adnanzami/IoT-based-Intelligent-Clothes-Dryer-Rack---Automated-Motorized-Cloth-Dryer-System/Schematics/motor driver schematic.jpg

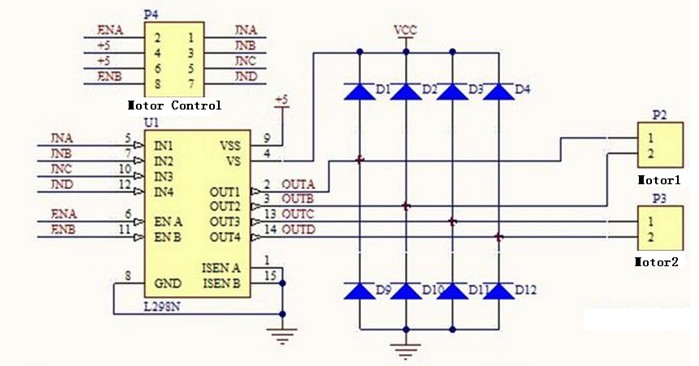
Schematics/motor driver schematic.jpg
