adnanzami/IoT-based-Intelligent-Clothes-Dryer-Rack---Automated-Motorized-Cloth-Dryer-System/Schematics/roller.jpg

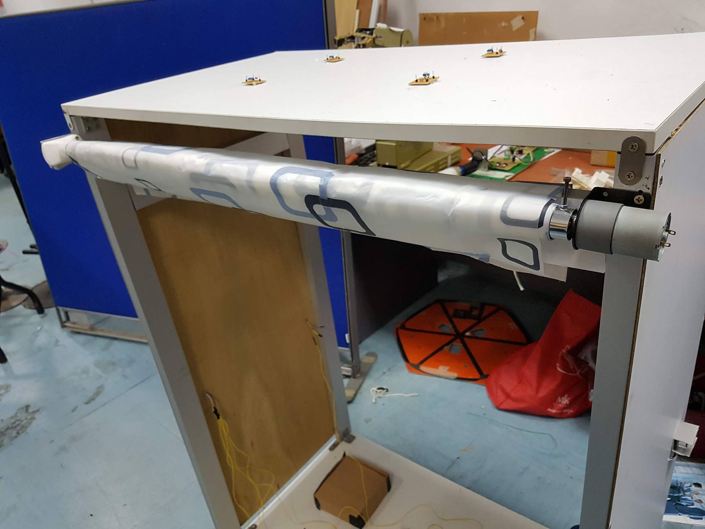
Schematics/roller.jpg
