adnanzami/IoT-based-Intelligent-Clothes-Dryer-Rack---Automated-Motorized-Cloth-Dryer-System/Code/LDR/LDR.png

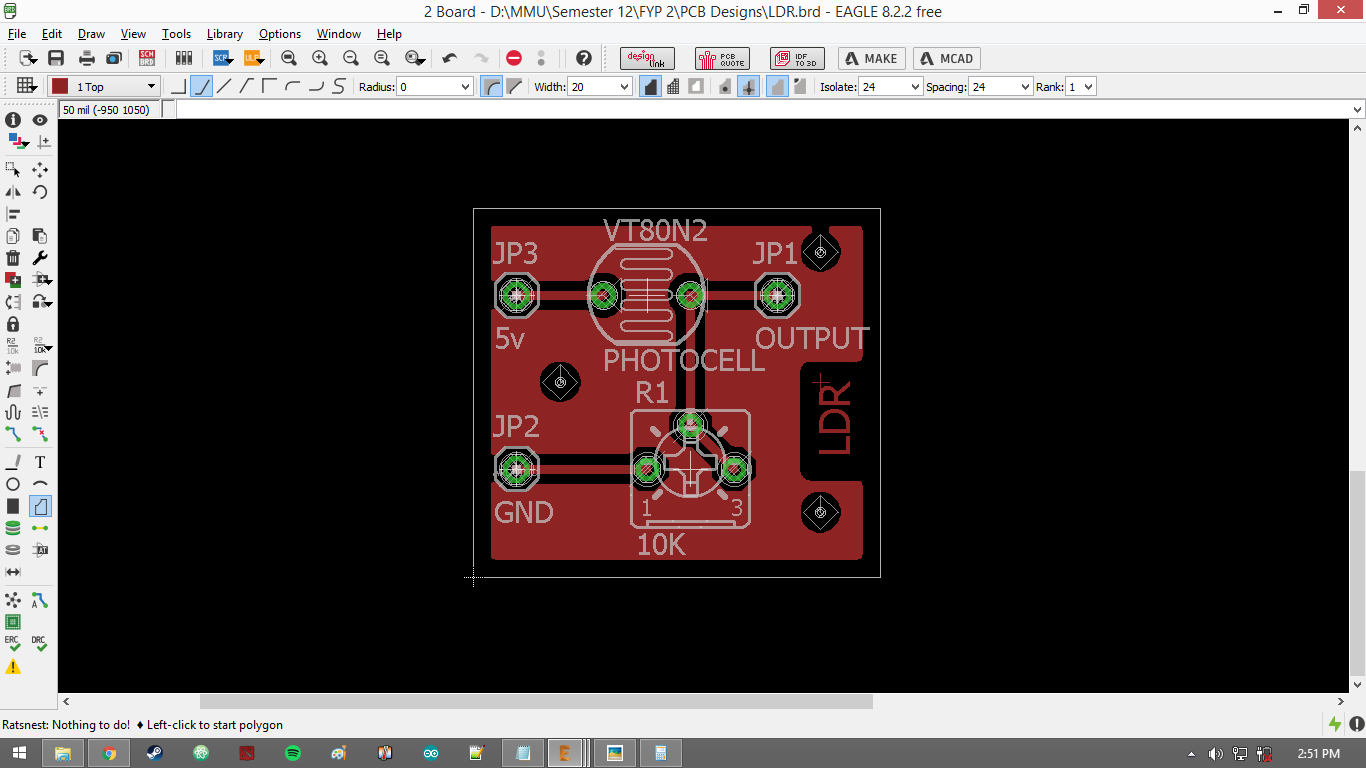
Code/LDR/LDR.png
