adnanzami/IoT-based-Intelligent-Clothes-Dryer-Rack---Automated-Motorized-Cloth-Dryer-System/Schematics/arduino mega.png

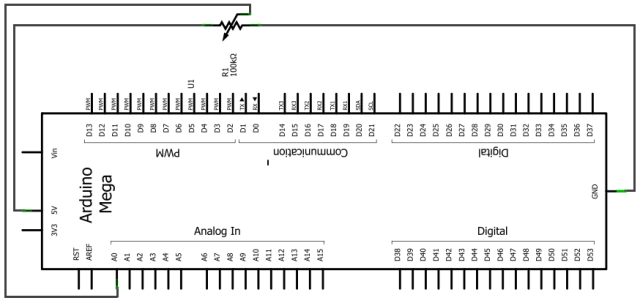
Schematics/arduino mega.png
