adnanzami/IoT-based-Intelligent-Clothes-Dryer-Rack---Automated-Motorized-Cloth-Dryer-System/Schematics/Figure 3.1.jpg

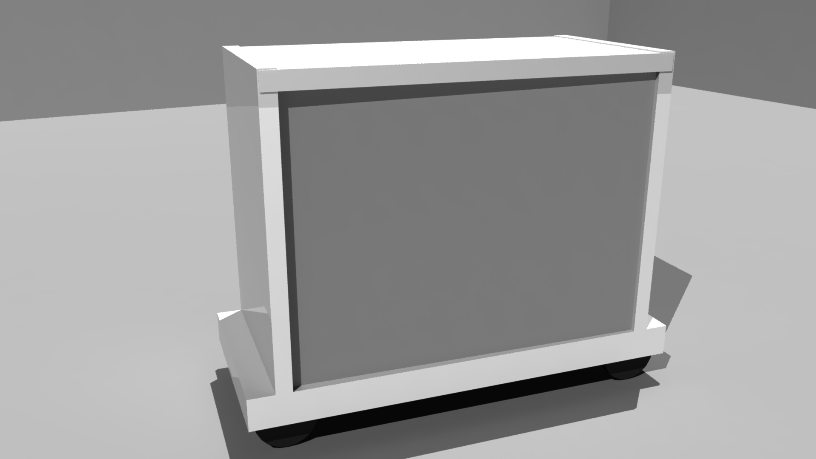
Schematics/Figure 3.1.jpg
